tvannoy/laser-photogate/README.md

# Laser photogate

This is a laser photogate timing system, designed primarily for Science Olympiad events such as Wheeled Vehicle, Battery Buggy, Gravity Vehicle, etc.
