tvannoy/laser-photogate/pcb/esp32-boards/README.md

# ESP32 wireless photogate hardware

[The KiCAD design files can be viewed online using KiCanvas.](https://kicanvas.org/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)
