tvannoy/laser-photogate/pcb/lipo-charger/lipo-charger.kicad_pcb

## KiCad design pcb/lipo-charger/lipo-charger.kicad_pcb (2024-04-13)

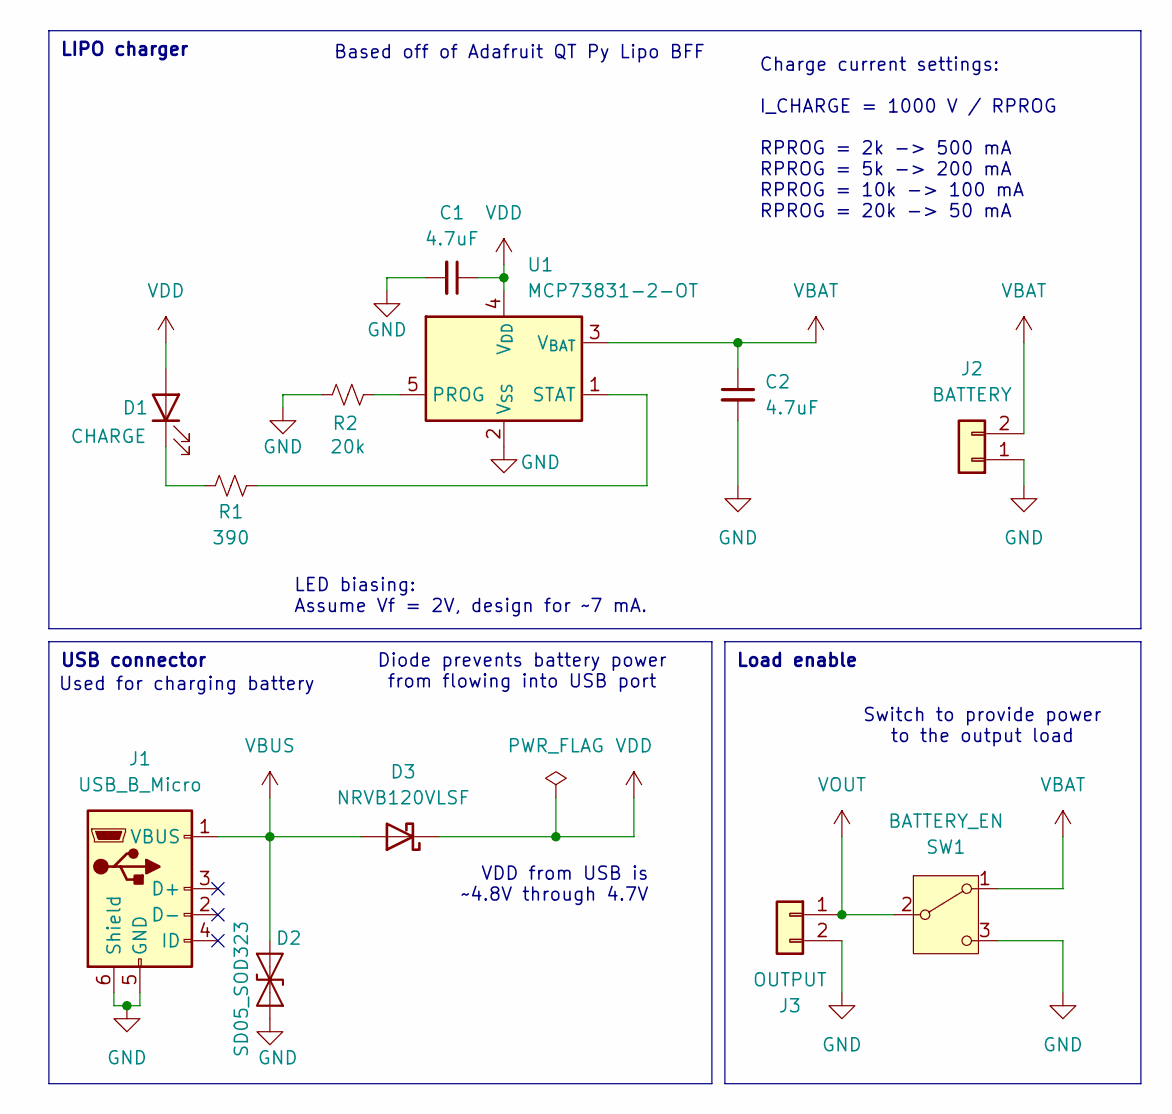
[picture p1: schematic lipo-charger.kicad_sch, lipo charger/supply]

Parts:
C1, C2: 4.7uF; C_0805_2012Metric_Pad1.18x1.45mm_HandSolder; Part Number CC0805KKX7R6BB475; JLC 0805
D1: CHARGE; LED_1206_3216Metric_Pad1.42x1.75mm_HandSolder; Part Number B1591UY--20C000112U1930; JLC 1206
D2: SD05_SOD323; D_SOD-323; Part Number Leiditech SD05; JLC SOD-323
D3: NRVB120VLSF; D_SOD-123F; Part Number SM5817PL-TP; JLC SOD-123FL
J1: USB_B_Micro; USB_Micro-B_Wuerth_629105150521; Part Number 629105150521
J2: BATTERY; JST_PH_B2B-PH-K_1x02_P2.00mm_Vertical; Part Number B2B-PH-K-S; JLCSC Part # C5251182
J3: OUTPUT; JST_PH_B2B-PH-K_1x02_P2.00mm_Vertical; Part Number B2B-PH-K-S; JLCSC Part # C5251182
R1: 390; R_0805_2012Metric_Pad1.20x1.40mm_HandSolder; Part Number RC0805FR-07390RL; JLC 0805
R2: 20k; R_0805_2012Metric_Pad1.20x1.40mm_HandSolder; Part Number RC0805FR-0720KL; JLC 0805
SW1: BATTERY_EN; SW_E-Switch_EG1224_SPDT_Angled; Part Number EG1224; JLCSC Part # C273395
U1: MCP73831-2-OT; SOT-23-5; Part Number MCP73831T-2ACI/OT; JLC SOT-23-5

Connections:
GND: C1.2, C2.2, D2.2 (A2), J1.5 (GND), J1.6 (Shield), J2.1, J3.2, R2.2, SW1.3 (C), U1.2 (V_{SS})
unnamed: D1.1 (K), R1.1
unnamed: R2.1, U1.5 (PROG)
unnamed: R1.2, U1.1 (STAT)
VBAT: C2.1, J2.2, SW1.1 (A), U1.3 (V_{BAT})
VBUS: D2.1 (A1), D3.2 (A), J1.1 (VBUS)
VDD: C1.1, D1.2 (A), D3.1 (K), U1.4 (V_{DD})
VOUT: J3.1, SW1.2 (B)

Notes on the sheet:
Load enable
USB connector
LIPO charger
VDD from USB is ~4.8V through 4.7V
Based off of Adafruit QT Py Lipo BFF
Charge current settings: I_CHARGE = 1000 V / RPROG RPROG = 2k -> 500 mA RPROG = 5k -> 200 mA RPROG = 10k -> 100 mA RPROG = 20k -> 50 mA
Diode prevents battery power from flowing into USB port
Used for charging battery
LED biasing: Assume Vf = 2V, design for ~7 mA.
Switch to provide power to the output load

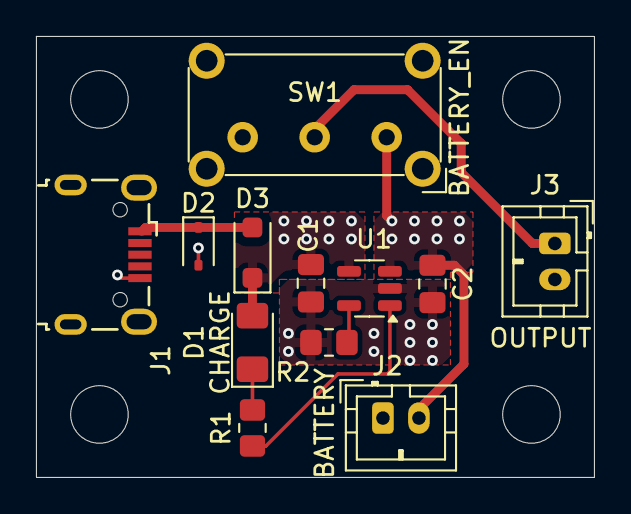
[picture p2: board lipo-charger.kicad_pcb from above]

Board: 2 copper layers, 31.0 x 24.5 mm, 12 parts (0 on the bottom side), 8 nets.
