tvannoy/laser-photogate/pcb/esp32-boards/esp32-boards.kicad_pcb

## KiCad design pcb/esp32-boards/esp32-boards.kicad_pcb (2024-04-09)

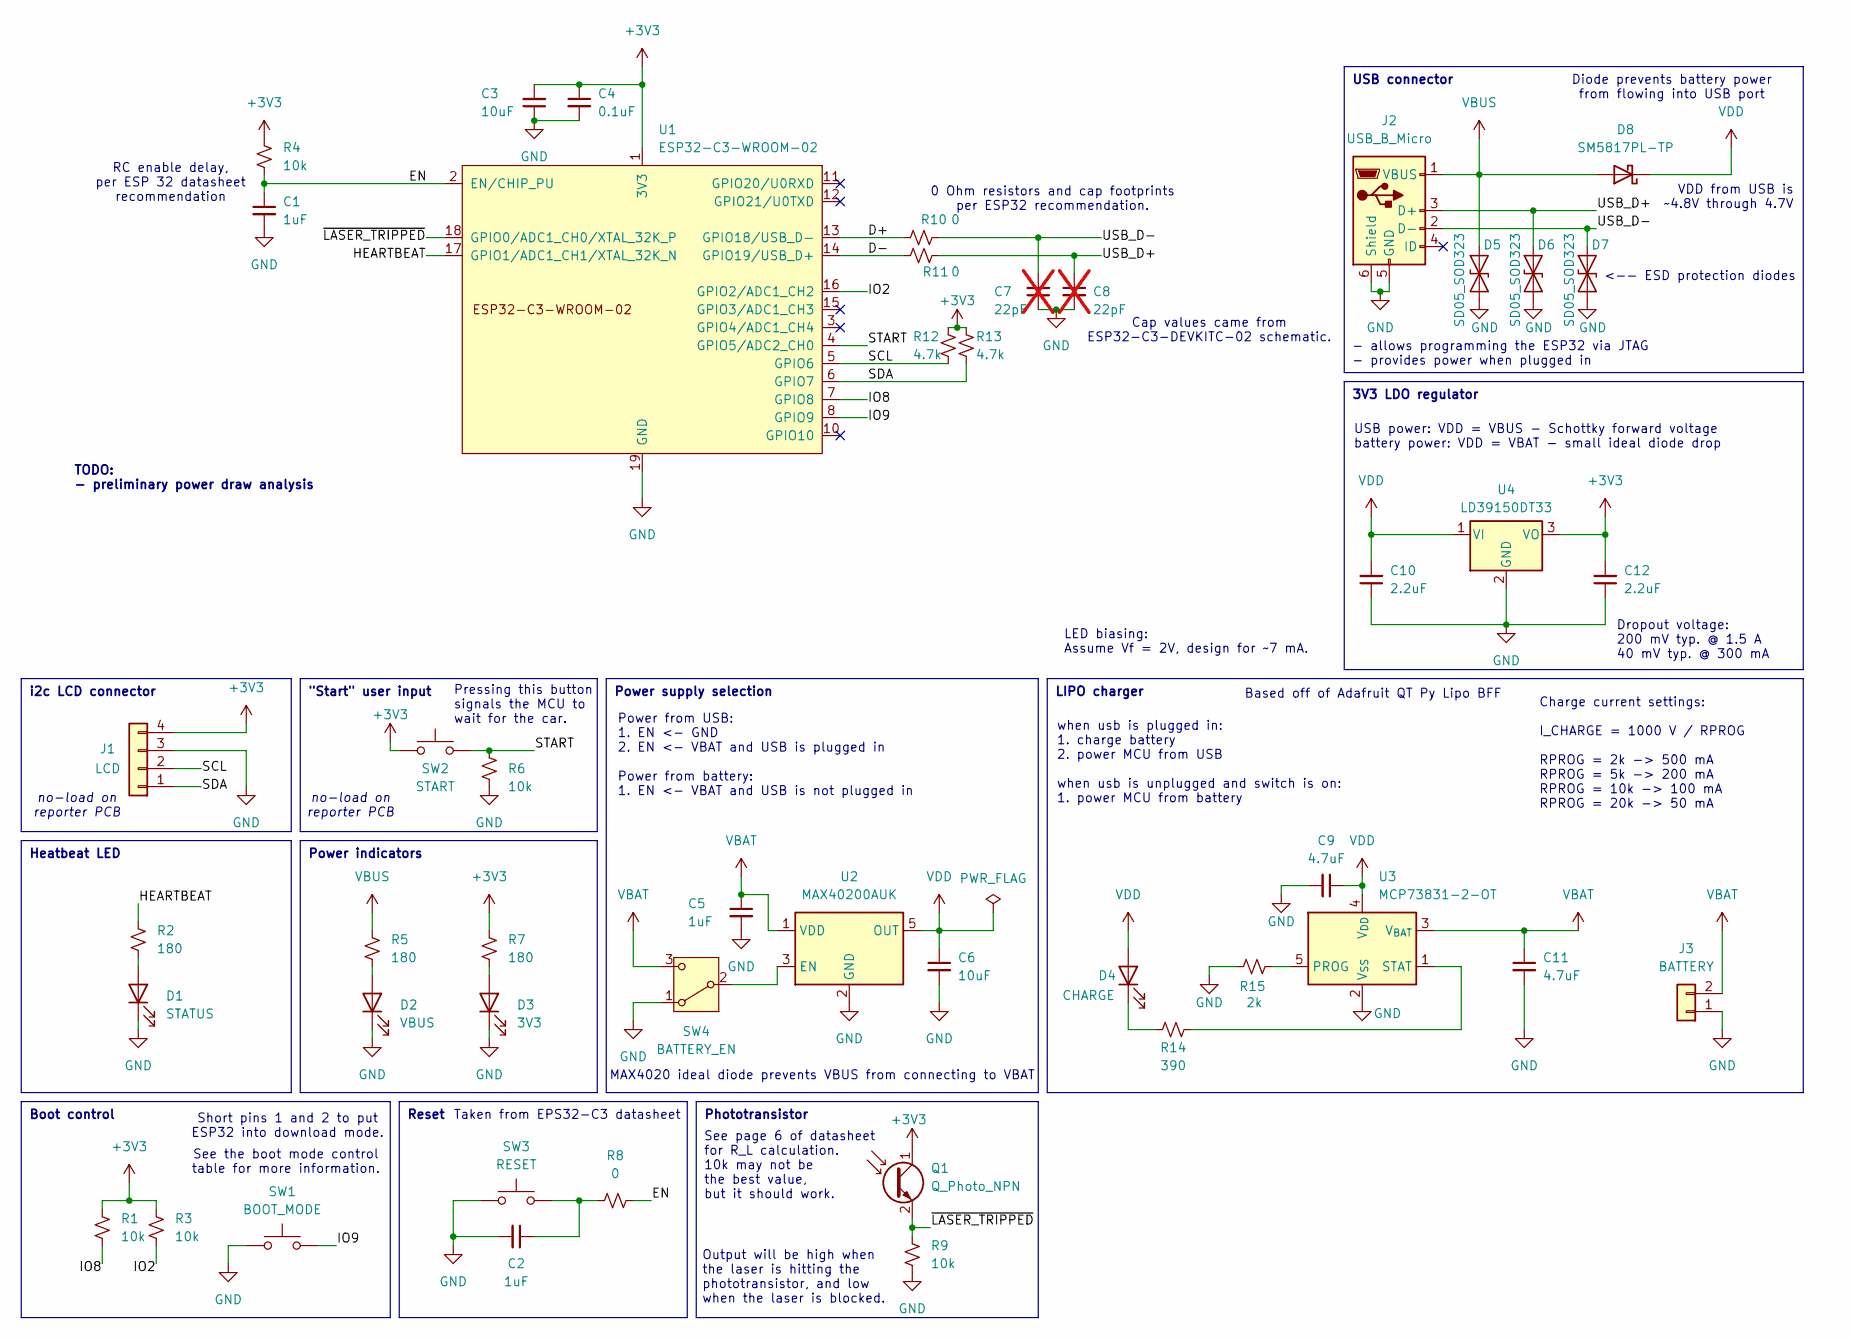
[picture p3: schematic esp32-boards.kicad_sch, laser photogate ESP32 board]

Parts:
C1, C2, C5: 1uF; C_0805_2012Metric_Pad1.18x1.45mm_HandSolder; Part Number CC0805KFX7R6BB106; JLC 0805
C3, C6: 10uF; C_0805_2012Metric_Pad1.18x1.45mm_HandSolder; Part Number CC0805KKX7R6BB105; JLC 0805
C4: 0.1uF; C_0805_2012Metric_Pad1.18x1.45mm_HandSolder; Part Number CC0805KRX7R6BB104; JLC 0805
C7, C8: 22pF; C_0805_2012Metric_Pad1.18x1.45mm_HandSolder; Part Number CC0805JRNPO9BN220; JLC 0805; not fitted
C9, C11: 4.7uF; C_0805_2012Metric_Pad1.18x1.45mm_HandSolder; Part Number CC0805KKX7R6BB475; JLC 0805
C10, C12: 2.2uF; C_0805_2012Metric_Pad1.18x1.45mm_HandSolder; Part Number CC0805KKX7R6BB225; JLC 0805
D1: STATUS; LED_1206_3216Metric_Pad1.42x1.75mm_HandSolder; Part Number B1591UY--20C000112U1930; JLC 1206
D2: VBUS; LED_1206_3216Metric_Pad1.42x1.75mm_HandSolder; Part Number B1591UY--20C000112U1930; JLC 1206
D3: 3V3; LED_1206_3216Metric_Pad1.42x1.75mm_HandSolder; Part Number B1591UY--20C000112U1930; JLC 1206
D4: CHARGE; LED_1206_3216Metric_Pad1.42x1.75mm_HandSolder; Part Number B1591UY--20C000112U1930; JLC 1206
D5, D6, D7: SD05_SOD323; D_SOD-323; Part Number Leiditech SD05; JLC SD-323
D8: SM5817PL-TP; D_SOD-123F; Part Number SM5817PL-TP; JLC SOD-123FL
J1: LCD; JST_PH_B4B-PH-K_1x04_P2.00mm_Vertical; Part Number B4B-PH-K-S; JLCSC C131334
J2: USB_B_Micro; USB_Micro-B_Wuerth_629105150521; Part Number 629105150521
J3: BATTERY; JST_PH_B2B-PH-K_1x02_P2.00mm_Vertical; Part Number B2B-PH-K-S; JLCSC C5251182
Q1: Q_Photo_NPN; LED_D3.0mm_Clear; Part Number ALS-PT204-6C/L177; JLCSC C2936540
R1, R3, R4, R6, R9: 10k; R_0805_2012Metric_Pad1.20x1.40mm_HandSolder; Part Number RC0805FR-0710KL; JLC 0805
R2, R5, R7: 180; R_0805_2012Metric_Pad1.20x1.40mm_HandSolder; Part Number RC0805FR-07180RL; JLC 0805
R8, R10, R11: 0; R_0805_2012Metric_Pad1.20x1.40mm_HandSolder; Part Number RC0805JR-070RL; JLC 0805
R12, R13: 4.7k; R_0805_2012Metric_Pad1.20x1.40mm_HandSolder; Part Number RC0805FR-074K7L; JLC 0805
R14: 390; R_0805_2012Metric_Pad1.20x1.40mm_HandSolder; Part Number RC0805FR-07390RL; JLC 0805
R15: 2k; R_0805_2012Metric_Pad1.20x1.40mm_HandSolder; Part Number RC0805FR-072KL; JLC 0805
SW1: BOOT_MODE; SW_PUSH_6mm_H4.3mm; Part Number TS02-66-43-BK-260-LCR-D
SW2: START; JST_PH_B2B-PH-K_1x02_P2.00mm_Vertical; Part Number B2B-PH-K-S; JLCSC C5251182
SW3: RESET; SW_PUSH_6mm_H4.3mm; Part Number TS02-66-43-BK-260-LCR-D
SW4: BATTERY_EN; SW_E-Switch_EG1224_SPDT_Angled; Part Number EG1224; JLCSC C273395
U1: ESP32-C3-WROOM-02; Part Number ESP32-C3-WROOM-02-N4; JLC VFQFN-32-EP
U2: MAX40200AUK; SOT-23-5; Part Number MAX40200AUK+T; JLC SOT-23-5
U3: MCP73831-2-OT; SOT-23-5; Part Number MCP73831T-2ACI/OT; JLC SOT-23-5
U4: LD39150DT33; TO-252-3_TabPin2; Part Number LD39150DT33-R; JLC TO-252

Connections:
+3V3: C3.2, C4.1, C12.2, J1.4, Q1.1 (C), R1.2, R3.2, R4.2, R7.1, R12.1, R13.1, SW2.1, U1.1 (3V3), U4.3 (VO)
/D+: R10.1, U1.13 (GPIO18/USB_D-)
/D-: R11.1, U1.14 (GPIO19/USB_D+)
/EN: C1.1, R4.1, R8.2, U1.2 (EN/CHIP_PU)
/HEARTBEAT: R2.1, U1.17 (GPIO1/ADC1_CH1/XTAL_32K_N)
/IO2: R3.1, U1.16 (GPIO2/ADC1_CH2)
/IO8: R1.1, U1.7 (GPIO8)
/IO9: SW1.2, U1.8 (GPIO9)
/SCL: J1.2, R12.2, U1.5 (GPIO6)
/SDA: J1.1, R13.2, U1.6 (GPIO7)
/START: R6.1, SW2.2, U1.4 (GPIO5/ADC2_CH0)
/USB_D+: C8.1, D6.1 (A1), J2.3 (D+), R11.2
/USB_D-: C7.2, D7.1 (A1), J2.2 (D-), R10.2
/~LASER_TRIPPED: Q1.2 (E), R9.1, U1.18 (GPIO0/ADC1_CH0/XTAL_32K_P)
GND: C1.2, C2.2, C3.1, C4.2, C5.2, C6.2, C7.1, C8.2, C9.2, C10.1, C11.2, C12.1, D1.1 (K), D2.1 (K), D3.1 (K), D5.2 (A2), D6.2 (A2), D7.2 (A2), J1.3, J2.5 (GND), J2.6 (Shield), J3.1, R6.2, R9.2, R15.2, SW1.1, SW3.1, SW4.1 (A), U1.9 (GND), U1.19 (GND), U2.2 (GND), U3.2 (V_{SS}), U4.2 (GND)
unnamed: C2.1, R8.1, SW3.2
unnamed: D1.2 (A), R2.2
unnamed: D2.2 (A), R5.2
unnamed: D3.2 (A), R7.2
unnamed: D4.1 (K), R14.1
unnamed: SW4.2 (B), U2.3 (EN)
unnamed: R15.1, U3.5 (PROG)
unnamed: R14.2, U3.1 (STAT)
VBAT: C5.1, C11.1, J3.2, SW4.3 (C), U2.1 (VDD), U3.3 (V_{BAT})
VBUS: D5.1 (A1), D8.2 (A), J2.1 (VBUS), R5.1
VDD: C6.1, C9.1, C10.2, D4.2 (A), D8.1 (K), U2.5 (OUT), U3.4 (V_{DD}), U4.1 (VI)

Notes on the sheet:
Heatbeat LED
Boot control
"Start" user input
Power indicators
Reset
USB connector
i2c LCD connector
Phototransistor
LIPO charger
3V3 LDO regulator
Power supply selection
Short pins 1 and 2 to put ESP32 into download mode.
Dropout voltage: 200 mV typ. @ 1.5 A 40 mV typ. @ 300 mA
when usb is plugged in: 1. charge battery 2. power MCU from USB when usb is unplugged and switch is on: 1. power MCU from battery
VDD from USB is ~4.8V through 4.7V
- allows programming the ESP32 via JTAG - provides power when plugged in
Based off of Adafruit QT Py Lipo BFF
Diode prevents battery power from flowing into USB port
0 Ohm resistors and cap footprints per ESP32 recommendation.
TODO: - preliminary power draw analysis
Power from USB: 1. EN <- GND 2. EN <- VBAT and USB is plugged in Power from battery: 1. EN <- VBAT and USB is not plugged in
no-load on reporter PCB
Output will be high when the laser is hitting the phototransistor, and low when the laser is blocked.
Pressing this button signals the MCU to wait for the car.
See page 6 of datasheet for R_L calculation. 10k may not be the best value, but it should work.
See the boot mode control table for more information.
MAX4020 ideal diode prevents VBUS from connecting to VBAT
Taken from EPS32-C3 datasheet
USB power: VDD = VBUS - Schottky forward voltage battery power: VDD = VBAT - small ideal diode drop
LED biasing: Assume Vf = 2V, design for ~7 mA.
Charge current settings: I_CHARGE = 1000 V / RPROG RPROG = 2k -> 500 mA RPROG = 5k -> 200 mA RPROG = 10k -> 100 mA RPROG = 20k -> 50 mA
RC enable delay, per ESP 32 datasheet recommendation
Cap values came from ESP32-C3-DEVKITC-02 schematic.
<-- ESD protection diodes

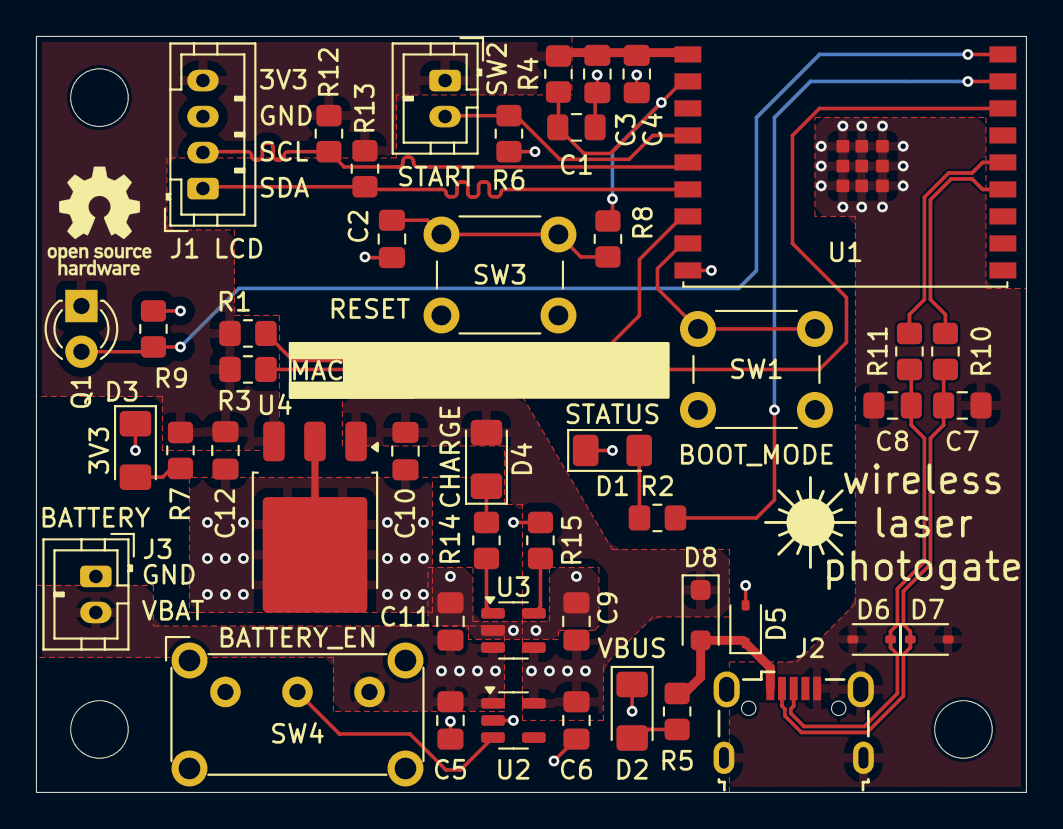
[picture p4: board esp32-boards.kicad_pcb from above]

Board: 2 copper layers, 55.0 x 42.0 mm, 48 parts (0 on the bottom side), 26 nets.

Other parts of the board:
svg2mod: G***; laser
