tvannoy/laser-photogate/pcb/reporter/reporter.kicad_pcb

## KiCad design pcb/reporter/reporter.kicad_pcb (2024-03-27)

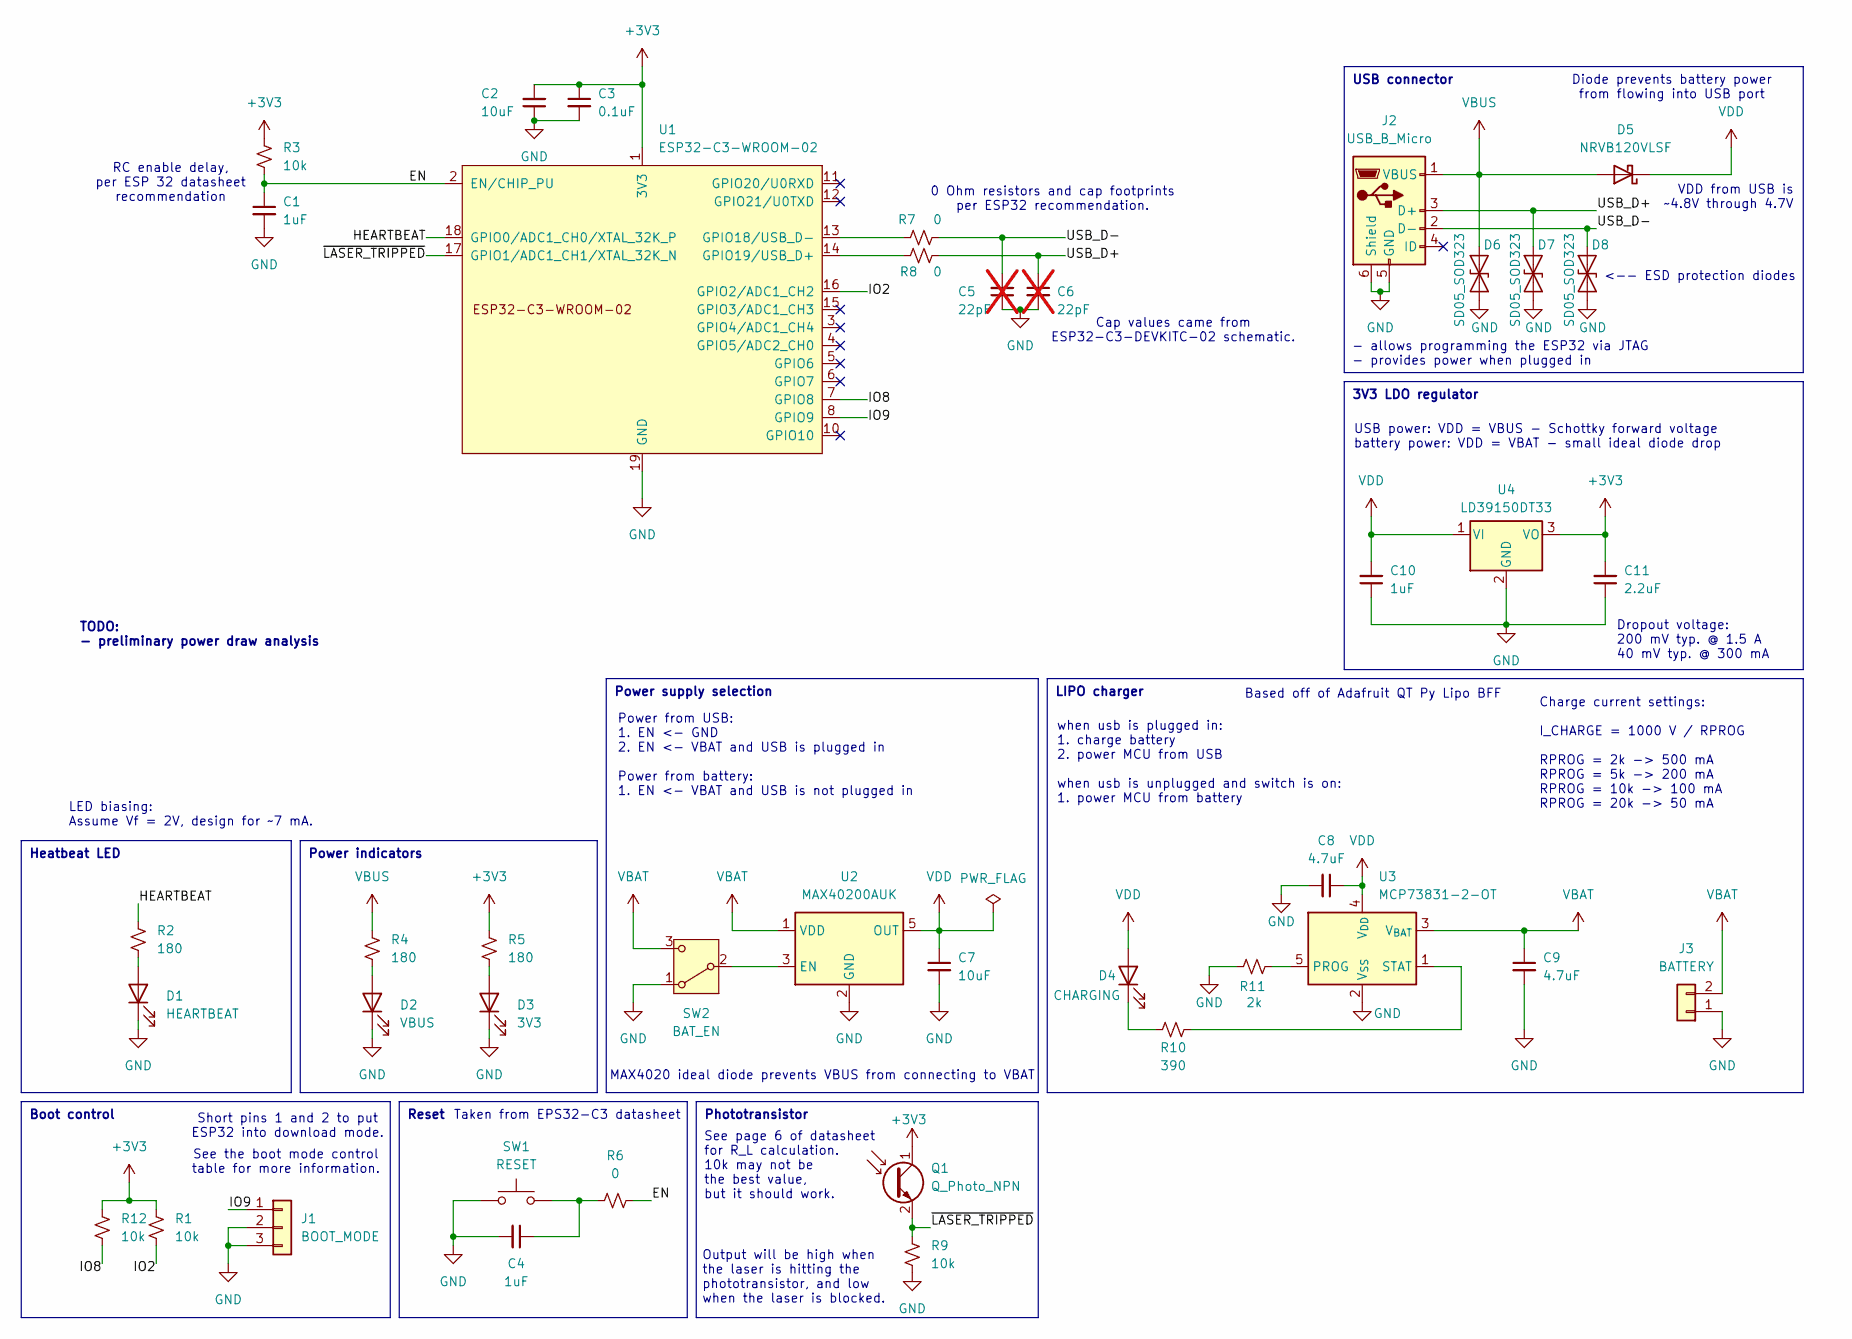
[picture p5: schematic reporter.kicad_sch, laser photogate reporter]

Parts:
C1, C4, C10: 1uF; C_1206_3216Metric_Pad1.33x1.80mm_HandSolder
C2, C7: 10uF; C_1206_3216Metric_Pad1.33x1.80mm_HandSolder
C3: 0.1uF; C_1206_3216Metric_Pad1.33x1.80mm_HandSolder
C5, C6: 22pF; C_1206_3216Metric_Pad1.33x1.80mm_HandSolder; not fitted
C8, C9: 4.7uF; C_1206_3216Metric_Pad1.33x1.80mm_HandSolder
C11: 2.2uF; C_1206_3216Metric_Pad1.33x1.80mm_HandSolder
D1: HEARTBEAT; LED_1206_3216Metric_Pad1.42x1.75mm_HandSolder; Part Number B1591UY--20C000112U1930
D2: VBUS; LED_1206_3216Metric_Pad1.42x1.75mm_HandSolder; Part Number B1591UY--20C000112U1930
D3: 3V3; LED_1206_3216Metric_Pad1.42x1.75mm_HandSolder; Part Number B1591UY--20C000112U1930
D4: CHARGING; LED_1206_3216Metric_Pad1.42x1.75mm_HandSolder; Part Number B1591UY--20C000112U1930
D5: NRVB120VLSF; D_SOD-123F; Part Number NRVB120VLSF
D6, D7, D8: SD05_SOD323; D_SOD-323; Part Number SD05C-7
J1: BOOT_MODE; PinHeader_1x03_P2.54mm_Vertical
J2: USB_B_Micro; USB_Micro-B_Wuerth_629105150521; Part Number 629105150521
J3: BATTERY; JST_PH_B2B-PH-K_1x02_P2.00mm_Vertical; Part Number B2B-XH-A
Q1: Q_Photo_NPN; LED_D3.0mm_Clear; Part Number ALS-PT204-6C/L177
R1, R3, R9, R12: 10k; R_1206_3216Metric_Pad1.30x1.75mm_HandSolder
R2, R4, R5: 180; R_1206_3216Metric_Pad1.30x1.75mm_HandSolder
R6, R7, R8: 0; R_1206_3216Metric_Pad1.30x1.75mm_HandSolder
R10: 390; R_1206_3216Metric_Pad1.30x1.75mm_HandSolder
R11: 2k; R_1206_3216Metric_Pad1.30x1.75mm_HandSolder
SW1: RESET; SW_PUSH_6mm_H4.3mm; Part Number TS02-66-43-BK-260-LCR-D
SW2: BAT_EN; SW_E-Switch_EG1224_SPDT_Angled; Part Number EG1224
U1: ESP32-C3-WROOM-02; Part Number ESP32-C3-WROOM-02-N4
U2: MAX40200AUK; SOT-23-5; Part Number MAX40200AUK+T
U3: MCP73831-2-OT; SOT-23-5; Part Number MCP73831T-2ACI/OT
U4: LD39150DT33; TO-252-3_TabPin2; Part Number LD39150DT33-R

Connections:
+3V3: C2.2, C3.1, C11.2, Q1.1 (C), R1.2, R3.2, R5.1, R12.2, U1.1 (3V3), U4.3 (VO)
/EN: C1.1, R3.1, R6.2, U1.2 (EN/CHIP_PU)
/HEARTBEAT: R2.1, U1.18 (GPIO0/ADC1_CH0/XTAL_32K_P)
/IO2: R1.1, U1.16 (GPIO2/ADC1_CH2)
/IO8: R12.1, U1.7 (GPIO8)
/IO9: J1.1, U1.8 (GPIO9)
/USB_D+: C6.1, D7.1 (A1), J2.3 (D+), R8.2
/USB_D-: C5.2, D8.1 (A1), J2.2 (D-), R7.2
/~LASER_TRIPPED: Q1.2 (E), R9.1, U1.17 (GPIO1/ADC1_CH1/XTAL_32K_N)
GND: C1.2, C2.1, C3.2, C4.2, C5.1, C6.2, C7.2, C8.2, C9.2, C10.1, C11.1, D1.1 (K), D2.1 (K), D3.1 (K), D6.2 (A2), D7.2 (A2), D8.2 (A2), J1.2, J1.3, J2.5 (GND), J2.6 (Shield), J3.1, R9.2, R11.2, SW1.1, SW2.1 (A), U1.9 (GND), U1.19 (GND), U2.2 (GND), U3.2 (V_{SS}), U4.2 (GND)
unnamed: C4.1, R6.1, SW1.2
unnamed: D1.2 (A), R2.2
unnamed: D2.2 (A), R4.2
unnamed: D3.2 (A), R5.2
unnamed: D4.1 (K), R10.1
unnamed: SW2.2 (B), U2.3 (EN)
unnamed: R7.1, U1.13 (GPIO18/USB_D-)
unnamed: R8.1, U1.14 (GPIO19/USB_D+)
unnamed: R11.1, U3.5 (PROG)
unnamed: R10.2, U3.1 (STAT)
VBAT: C9.1, J3.2, SW2.3 (C), U2.1 (VDD), U3.3 (V_{BAT})
VBUS: D5.2 (A), D6.1 (A1), J2.1 (VBUS), R4.1
VDD: C7.1, C8.1, C10.2, D4.2 (A), D5.1 (K), U2.5 (OUT), U3.4 (V_{DD}), U4.1 (VI)

Notes on the sheet:
Heatbeat LED
Boot control
Power indicators
Reset
USB connector
Phototransistor
LIPO charger
3V3 LDO regulator
Power supply selection
Short pins 1 and 2 to put ESP32 into download mode.
Dropout voltage: 200 mV typ. @ 1.5 A 40 mV typ. @ 300 mA
when usb is plugged in: 1. charge battery 2. power MCU from USB when usb is unplugged and switch is on: 1. power MCU from battery
VDD from USB is ~4.8V through 4.7V
- allows programming the ESP32 via JTAG - provides power when plugged in
Based off of Adafruit QT Py Lipo BFF
Diode prevents battery power from flowing into USB port
0 Ohm resistors and cap footprints per ESP32 recommendation.
TODO: - preliminary power draw analysis
Power from USB: 1. EN <- GND 2. EN <- VBAT and USB is plugged in Power from battery: 1. EN <- VBAT and USB is not plugged in
Output will be high when the laser is hitting the phototransistor, and low when the laser is blocked.
See page 6 of datasheet for R_L calculation. 10k may not be the best value, but it should work.
See the boot mode control table for more information.
MAX4020 ideal diode prevents VBUS from connecting to VBAT
Taken from EPS32-C3 datasheet
USB power: VDD = VBUS - Schottky forward voltage battery power: VDD = VBAT - small ideal diode drop
LED biasing: Assume Vf = 2V, design for ~7 mA.
Charge current settings: I_CHARGE = 1000 V / RPROG RPROG = 2k -> 500 mA RPROG = 5k -> 200 mA RPROG = 10k -> 100 mA RPROG = 20k -> 50 mA
RC enable delay, per ESP 32 datasheet recommendation
Cap values came from ESP32-C3-DEVKITC-02 schematic.
<-- ESD protection diodes

Board: 2 copper layers, 41 parts (0 on the bottom side), 23 nets, no tracks yet.
