tvannoy/laser-photogate/(commit log)

2024-03-26 add kicad gitignore template
2024-03-26 add reporter schematic
    [reporter.kicad_pcb, reporter.kicad_sch]
2024-03-27 replace ESD diodes with larger package
    [reporter.kicad_sch]
2024-03-27 use USB connector with board guides
    [reporter.kicad_sch]
2024-03-27 place components in preliminary locations
    This is just the initial component placement. Some changes will
    inevitably happen.
    [reporter.kicad_pcb]
2024-03-27 rename reporter to a generic name
    The same PCB can be used for the reporter and controller. They are
    essentially the same, except the controller will have a few more
    components. These components can be no-loaded for the reporter.
    [esp32-boards.kicad_pcb, esp32-boards.kicad_sch]
2024-03-28 add LCD and start button
    [esp32-boards.kicad_sch]
2024-03-28 switch to 0805 for most components
    [esp32-boards.kicad_pcb, esp32-boards.kicad_sch]
2024-03-28 update battery switch name
    [esp32-boards.kicad_sch]
2024-03-29 finish first draft of layout
    [esp32-boards.kicad_pcb, esp32-boards.kicad_sch]
2024-03-29 add screenshot of differential impedance calculation
    [esp32-boards.kicad_pcb]
2024-03-29 update reference designators
    [esp32-boards.kicad_pcb, esp32-boards.kicad_sch]
2024-03-29 add documentation; move board; resize VBAT pour
    [esp32-boards.kicad_pcb]
2024-03-30 add usb connector 3d model
2024-03-30 create laser graphic
2024-03-30 add final touches on silkscreen
    [esp32-boards.kicad_pcb]
2024-03-30 add project-based footprint library
2024-03-30 set up DRC and fix DRC errors
    [esp32-boards.kicad_pcb]
2024-03-30 create circuit for charging lipo and powering laser
    [lipo-charger.kicad_pcb, lipo-charger.kicad_sch]
2024-03-30 set grid origin
    [esp32-boards.kicad_pcb]
2024-03-31 update BOMs for JLC assembly
    [esp32-boards.kicad_sch, lipo-charger.kicad_sch]
2024-03-31 add tooling holes for assembly
    https://jlcpcb.com/help/article/47-How-to-add-tooling-holes-for-PCB-assembly-order
    [esp32-boards.kicad_pcb, lipo-charger.kicad_pcb]
2024-03-31 remove tooling holes; finalize for production
    It's easier to have JLC add the tooling holes.
    [esp32-boards.kicad_pcb, esp32-boards.kicad_sch, lipo-charger.kicad_pcb]
2024-04-01 add download script and links to datasheets
    I'd like to keep all the datasheets alongside the repository, but
    don't want to track them in git.
2024-04-09 add LED spacer for enclosure considerations
    I want the LED to spaced higher off the board so the converging lens in
    the enclosure can be centered on the LED without the board having to be
    so high up in the enclosure. This will make the PCB standoffs shorter
    and give more space for the LCD and pushbutton wiring.
    [esp32-boards.kicad_pcb]
2024-04-13 fix path to USB 3D model
    [lipo-charger.kicad_pcb]
