tvannoy/laser-photogate/(notices)

Notices in the files:
pcb/lipo-charger/lipo-charger.kicad_pcb:
License: CERN-OHL-S-2.0
pcb/esp32-boards/esp32-boards.kicad_pcb:
© Trevor Vannoy
SPDX-License-Identifier: CERN-OHL-S-2.0
